ianlane1/3x3MOSFETMultiplier/SchematicFiles/MOSFET Testing.asc

A1: voltage; 5
A2: voltage; 5
A3: voltage; 5
B1: voltage; 5
B2: voltage; 5
B3: voltage; 5
M1: nmos; 2N7002
M2: nmos; 2N7002
M3: nmos; 2N7002
M5: nmos; 2N7002
M6: nmos; 2N7002
M7: nmos; 2N7002
M8: nmos; 2N7002
M9: nmos; 2N7002
M10: nmos; 2N7002
M11: nmos; 2N7002
M12: nmos; 2N7002
M13: nmos; 2N7002
M14: nmos; 2N7002
M15: nmos; 2N7002
M16: nmos; 2N7002
M17: nmos; 2N7002
M18: nmos; 2N7002
M19: nmos; 2N7002
M20: nmos; 2N7002
M21: nmos; 2N7002
M22: nmos; 2N7002
M23: nmos; 2N7002
M24: nmos; 2N7002
M25: nmos; 2N7002
M26: nmos; 2N7002
M27: nmos; 2N7002
M28: nmos; 2N7002
M29: nmos; 2N7002
M30: nmos; 2N7002
M31: nmos; 2N7002
M32: nmos; 2N7002
M33: nmos; 2N7002
M34: nmos; 2N7002
M35: nmos; 2N7002
M36: nmos; 2N7002
M37: nmos; 2N7002
M38: nmos; 2N7002
M39: nmos; 2N7002
M40: nmos; 2N7002
M41: nmos; 2N7002
M42: nmos; 2N7002
M43: nmos; 2N7002
M44: nmos; 2N7002
M45: nmos; 2N7002
M46: nmos; 2N7002
M47: nmos; 2N7002
M48: nmos; 2N7002
M49: nmos; 2N7002
M50: nmos; 2N7002
M51: nmos; 2N7002
M52: nmos; 2N7002
M53: nmos; 2N7002
M54: nmos; 2N7002
M55: nmos; 2N7002
M56: nmos; 2N7002
M57: nmos; 2N7002
M58: nmos; 2N7002
M59: nmos; 2N7002
M60: nmos; 2N7002
M61: nmos; 2N7002
M66: nmos; 2N7002
M67: nmos; 2N7002
M68: nmos; 2N7002
M69: nmos; 2N7002
M70: nmos; 2N7002
M71: nmos; 2N7002
M72: nmos; 2N7002
M73: nmos; 2N7002
M74: nmos; 2N7002
M75: nmos; 2N7002
M76: nmos; 2N7002
M77: nmos; 2N7002
M78: nmos; 2N7002
M79: nmos; 2N7002
M80: nmos; 2N7002
M82: nmos; 2N7002
M83: nmos; 2N7002
M84: nmos; 2N7002
M85: nmos; 2N7002
M86: nmos; 2N7002
M87: nmos; 2N7002
M88: nmos; 2N7002
M89: nmos; 2N7002
M90: nmos; 2N7002
M91: nmos; 2N7002
M92: nmos; 2N7002
M93: nmos; 2N7002
M94: nmos; 2N7002
M95: nmos; 2N7002
M96: nmos; 2N7002
M97: nmos; 2N7002
M98: nmos; 2N7002
M99: nmos; 2N7002
M100: nmos; 2N7002
M101: nmos; 2N7002
M102: nmos; 2N7002
M103: nmos; 2N7002
M104: nmos; 2N7002
M106: nmos; 2N7002
M107: nmos; 2N7002
M108: nmos; 2N7002
M109: nmos; 2N7002
M110: nmos; 2N7002
M111: nmos; 2N7002
M112: nmos; 2N7002
M117: nmos; 2N7002
M118: nmos; 2N7002
M119: nmos; 2N7002
M121: nmos; 2N7002
M122: nmos; 2N7002
R1: res; 1k
R2: res; 1k
R3: res; 1k
R4: res; 1k
R5: res; 1k
R6: res; 1k
R7: res; 1k
R8: res; 1k
R9: res; 1k
R10: res; 1k
R11: res; 1k
R12: res; 1k
R13: res; 1k
R14: res; 1k
R15: res; 1k
R16: res; 1k
R17: res; 1k
R18: res; 1k
R19: res; 1k
R20: res; 1k
R21: res; 1k
R22: res; 1k
R23: res; 1k
R24: res; 1k
R25: res; 1k
R26: res; 1k
R27: res; 1k
R28: res; 1k
R29: res; 1k
R30: res; 1k
R31: res; 1k
R32: res; 1k
R34: res; 1k
R35: res; 1k
R36: res; 1k
R37: res; 1k
R38: res; 1k
R39: res; 1k
R40: res; 1k
R41: res; 1k
R42: res; 1k
R43: res; 1k
R44: res; 1k
R45: res; 1k
R46: res; 1k
R47: res; 1k
R48: res; 1k
R49: res; 1k
R53: res; 1k
R54: res; 1k
V1: voltage; 5
V2: voltage; 5
V3: voltage; 5
V4: voltage; 5
V5: voltage; 5
V8: voltage; 5
V9: voltage; 5
V10: voltage; 5
V11: voltage; 5
V12: voltage; 5
V13: voltage; 5
V14: voltage; 5
V15: voltage; 5
V16: voltage; 5
V17: voltage; 5
V18: voltage; 5
V19: voltage; 5
V20: voltage; 5
V22: voltage; 5
V23: voltage; 5
V24: voltage; 5
V25: voltage; 5
V26: voltage; 5
V27: voltage; 5
V28: voltage; 5
V29: voltage; 5
V30: voltage; 5
V31: voltage; 5
V32: voltage; 5
V33: voltage; 5
V37: voltage; 5
V38: voltage; 5
Named nets: 0, A2B1, NAND, A3B1, A1B1, A2B2, A3B2, A1B2, A2B3, A3B3, A1B3, D1, D2, C2, 3_1, 3_2, D3, C3_2, C3_1, 4_1, D4, C4, D5, D6, C4_1
.tran 1
Td1 20ns Td2 30ns Tc2 40ns Td3 70ns Tc3_1 60ns Tc3_2 90ns
Td4 120ns Tc4 160ns Td5 170ns Td6 190ns
60ns
