ianlane1/3x3MOSFETMultiplier/SchematicFiles/NMOS Logic.asc

A: voltage; 0
B: voltage; 0
C: voltage; 0
D: voltage; 0
E: voltage; 5
F: voltage; 0
M1: nmos; 2N7002
M2: nmos; 2N7002
M3: nmos; 2N7002
M4: nmos; 2N7002
M5: nmos; 2N7002
M6: nmos; 2N7002
M7: nmos; 2N7002
M8: nmos; 2N7002
M9: nmos; 2N7002
M10: nmos; 2N7002
R1: res; 1k
R2: res; 1k
R3: res; 1k
R4: res; 1k
R5: res; 1k
V1: voltage; 5
V2: voltage; 5
V3: voltage; 5
~E: voltage; 0
~F: voltage; 5
Named nets: 0, AND, OR, XOR
.tran 1
