ianlane1/3x3MOSFETMultiplier/(commit log)

2025-01-01 Renamed file and added description and stage 1 testing
2025-01-09 Added stage 2 testing
2025-01-16 Added stage 3 video
2025-01-16 Created a folder for the updates in the schematic
2025-01-16 Moved logic gate schematic into a folder
2025-01-16 Updated version of original schematic
    Changed C3.1 as well as C5 to match what I updated in the videos as well as in the document
2025-01-16 Updated the design of project
    Changed the schematic picture to the updated version. Also changed the carry bits and truth tables to minimize the amount of transistors being used.
2025-01-26 Added stage 4 and full scale testing video links
